will-hut/Rocket_FC/Hardware/Flight_Board/Flight_Board.pdf

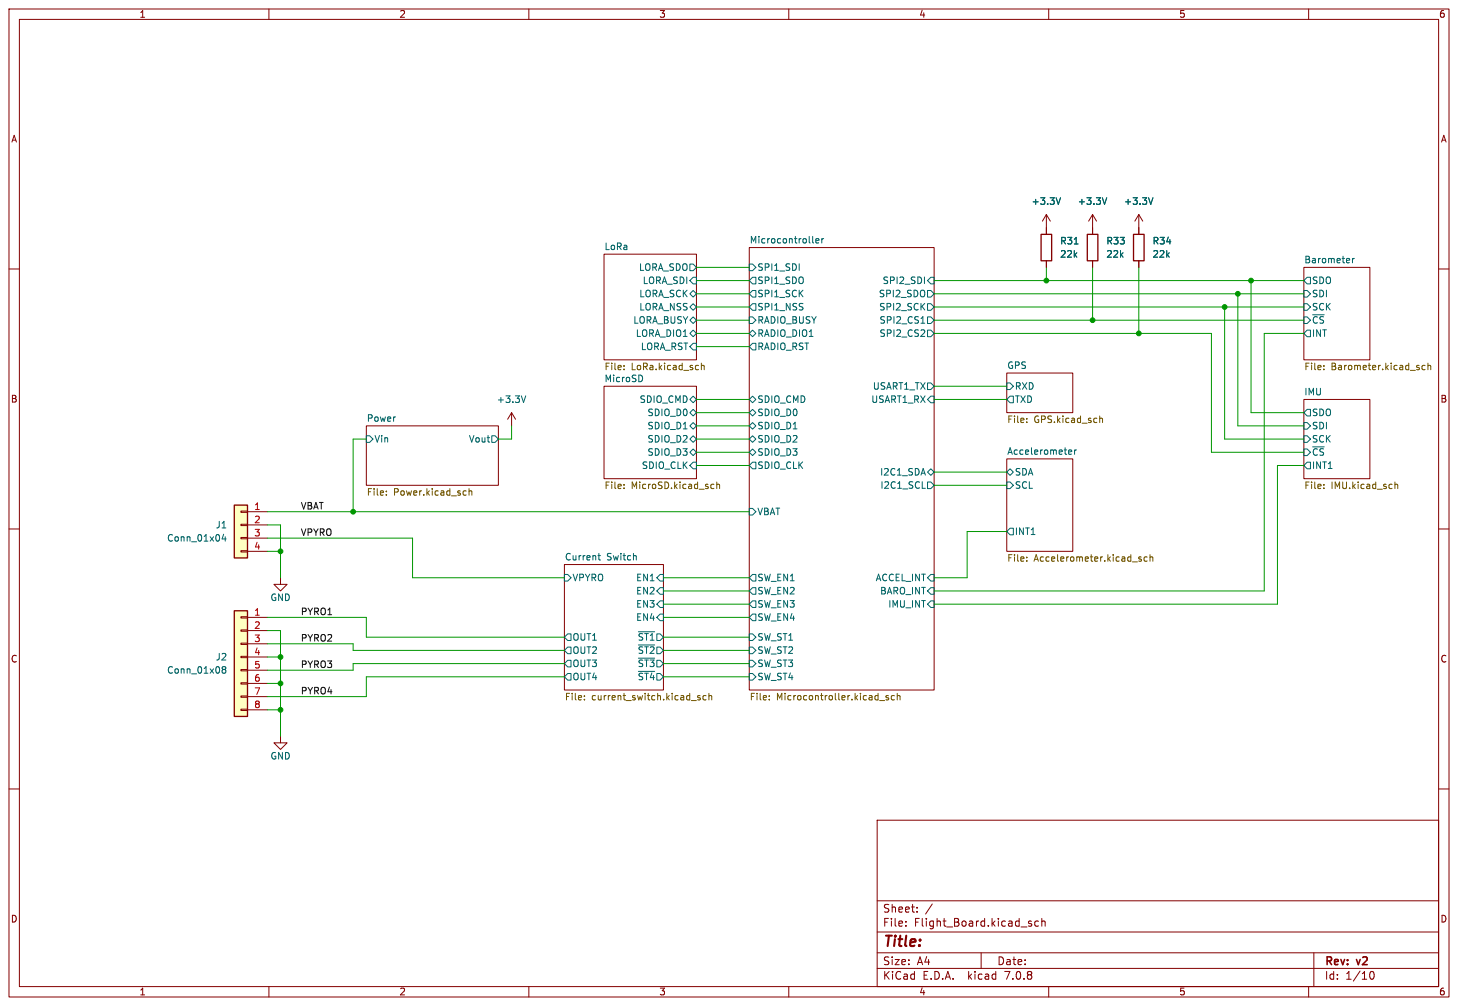
[picture p1: page 1]

INT Barometer File: Barometer.kicad_sch RXD

Id: 1/10 Title: File: Flight_Board.kicad_sch Sheet: /

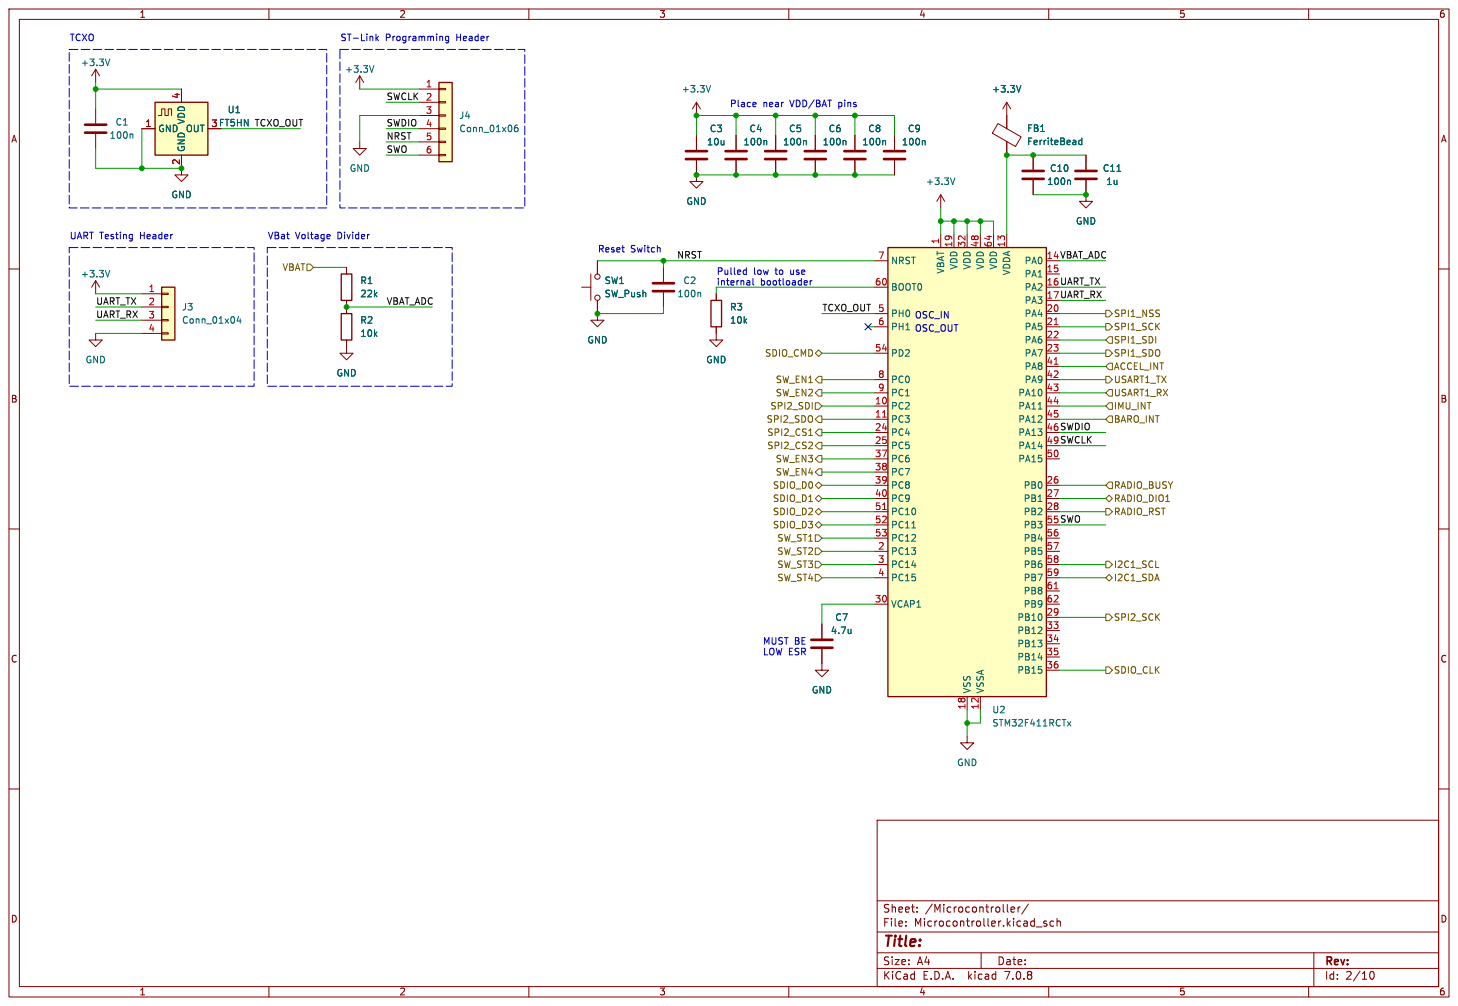
[picture p2: page 2]

UART Testing Header TCXO

TCXO_OUT SWCLK
Place near VDD/BAT pins R1
NRST SWDIO
NRST
SWO

1 PC2 10 PC3 11 VSSA 12 VDDA 13 PA0 14 PA1 15 PA2 16 PA3 17 VSS 18 VDD 19 PC13 2 PA4 20 PA5 21 PA6 22 PA7 23 PC4 24 PC5 25 PB0 26 PB1 27 PB2 28 PB10 29 PC14 3 VCAP1 30 VDD 32 PB12 33 PB13 34 PB14 35 PB15 36 PC6 37 PC7 38 PC8 39 PC15 4 PC9 40 PA8 41 PA9 42 PA10 43 PA11 44 PA12 45 PA13 46 VDD 48 PA14 49 PH0 5 PA15 50 PC10 51 PC11 52 PC12 53 PD2 54 PB3 55 PB4 56 PB5 57 PB6 58 PB7 59 PH1 6 BOOT0 60 PB8 61 PB9 62 VDD 64 NRST 7 PC0 8 PC1 9 U2STM32F411RCTx

Id: 2/10 Title: File: Microcontroller.kicad_sch Sheet: /Microcontroller/

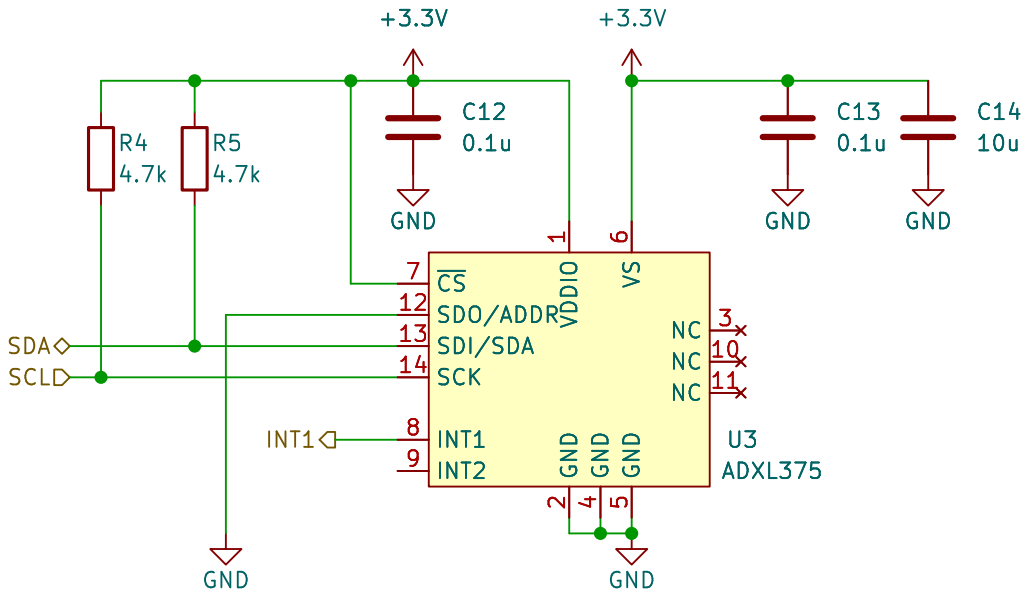
[picture p3: page 3]

1 NC 10 NC 11 SDO/ADDR 12 SDI/SDA 13 SCK 14 GND

Id: 3/10 Title: File: Accelerometer.kicad_sch Sheet: /Accelerometer/

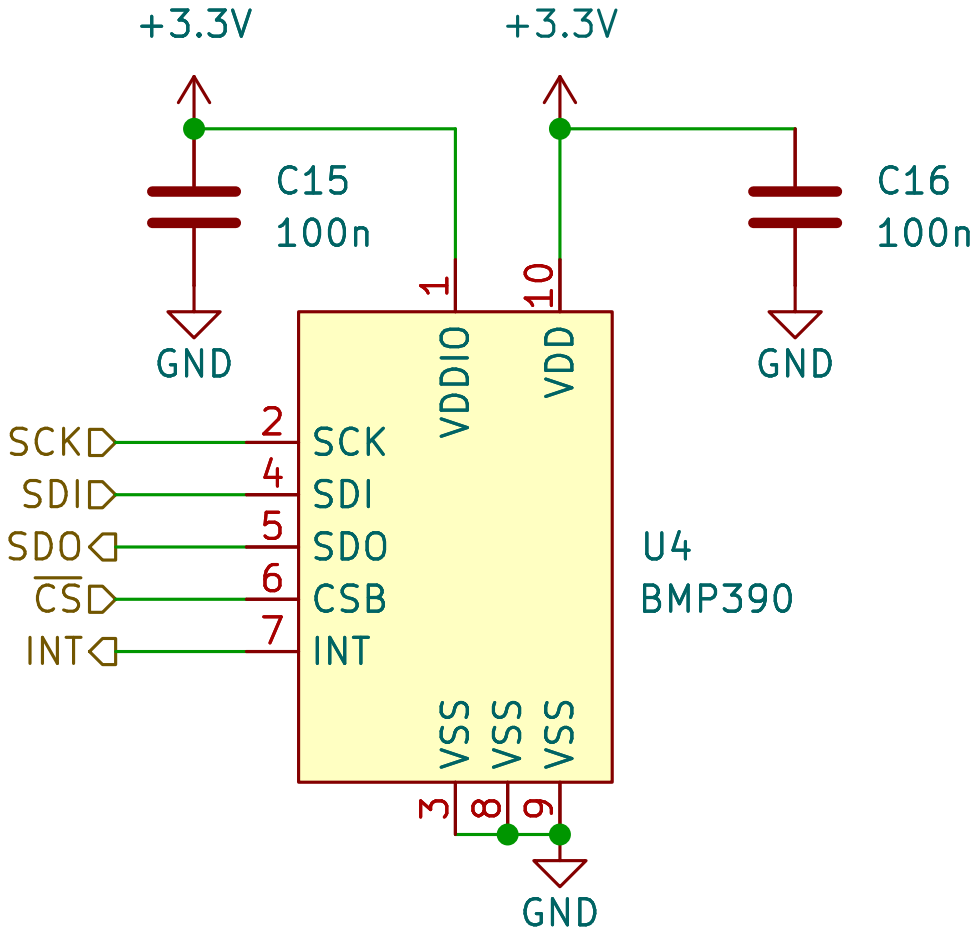
[picture p4: page 4]

Id: 4/10 Title: File: Barometer.kicad_sch Sheet: /Barometer/ VDDIO

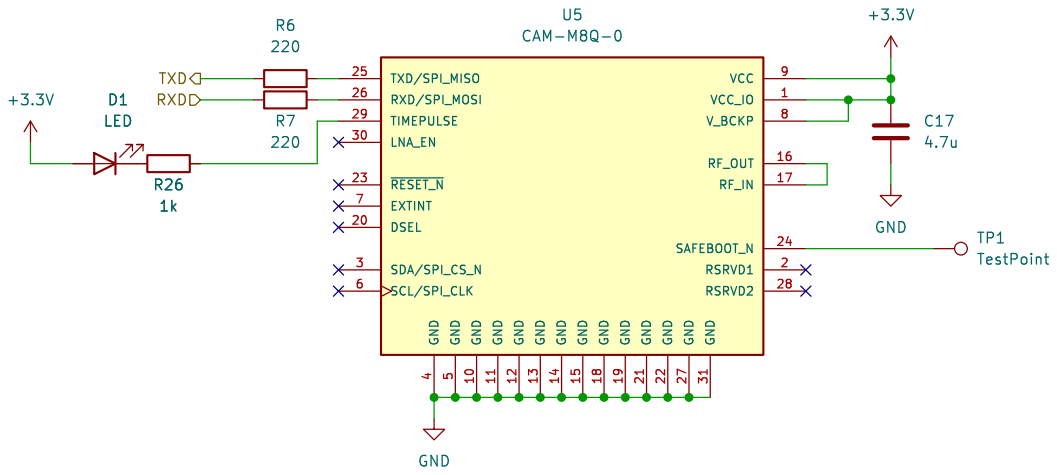
[picture p5: page 5]

5 SCL/SPI_CLK 6 EXTINT 7 V_BCKP 8 VCC 9 U5 CAM-M8Q-0 +3.3V

Id: 5/10 Title: File: GPS.kicad_sch Sheet: /GPS/ GND

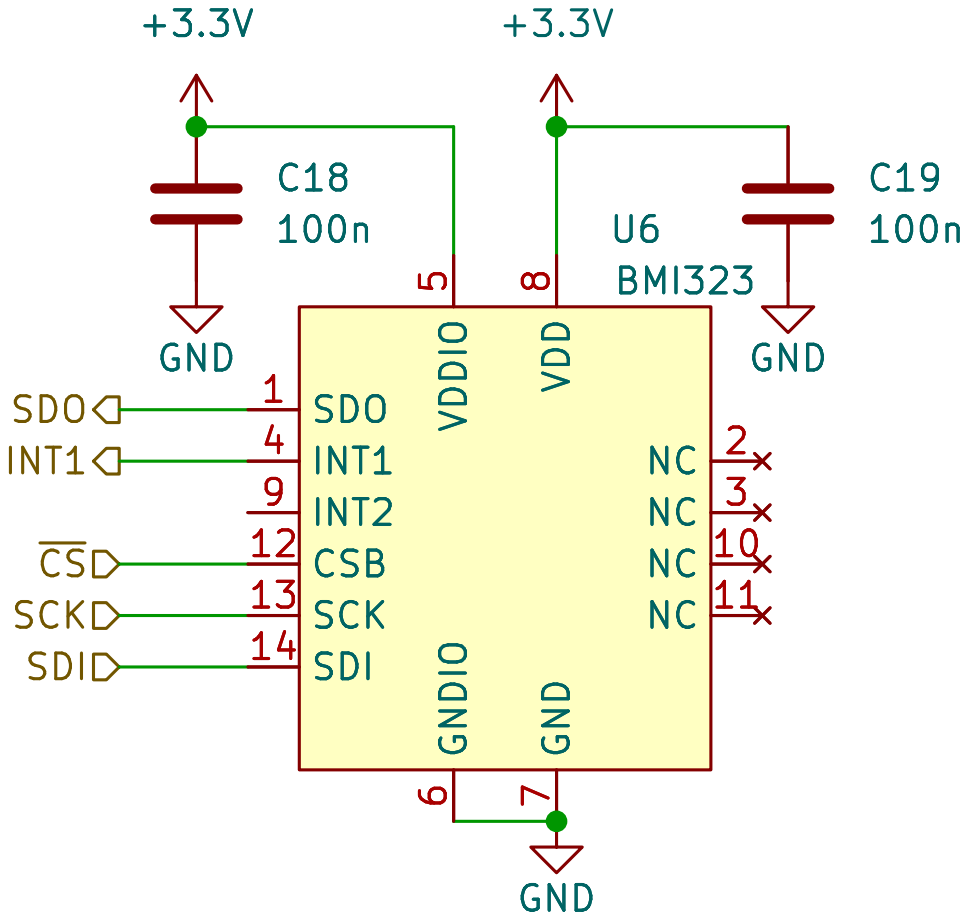
[picture p6: page 6]

Id: 6/10 Title: File: IMU.kicad_sch Sheet: /IMU/ GND

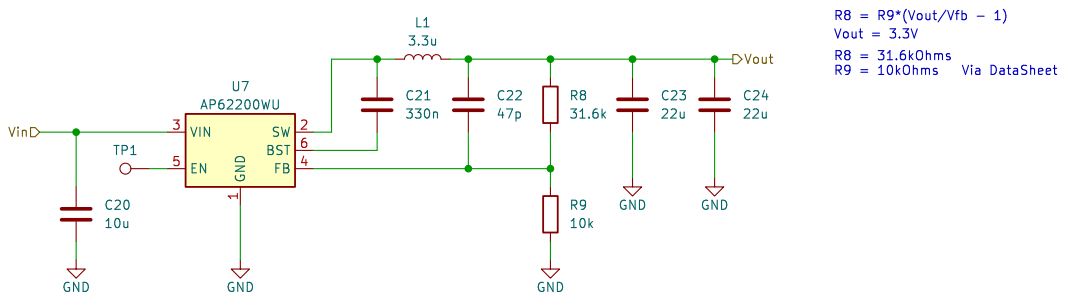
[picture p7: page 7]

1 SW 2 VIN 3 FB 4 EN 5 BST 6 U7 AP62200WU GND

Id: 7/10 Title: File: Power.kicad_sch Sheet: /Power/

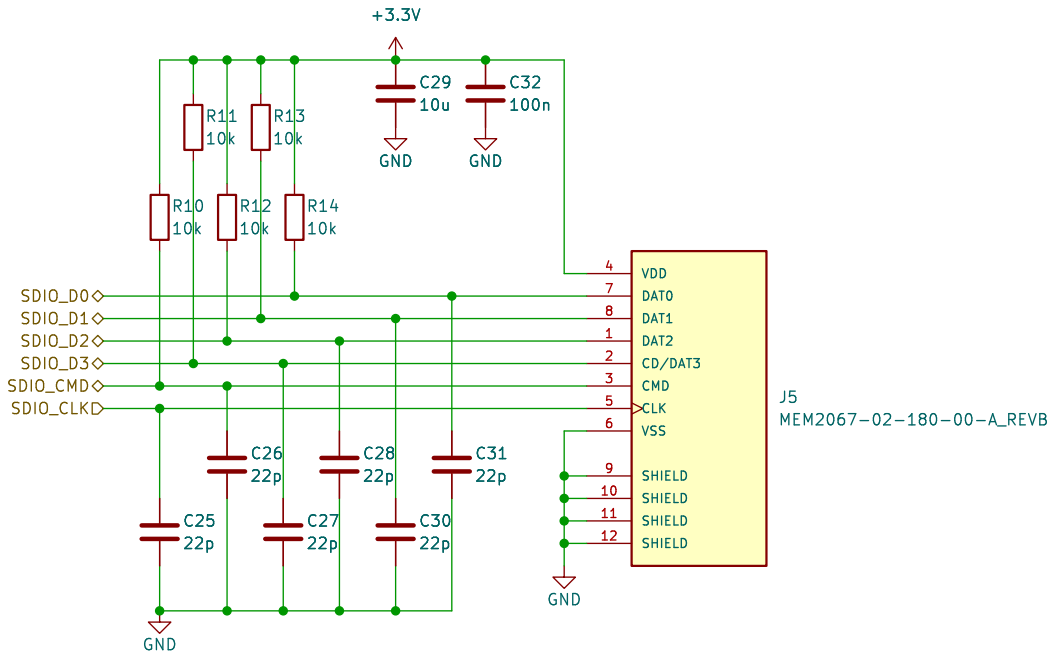
[picture p8: page 8]

Id: 8/10 Title: File: MicroSD.kicad_sch Sheet: /MicroSD/

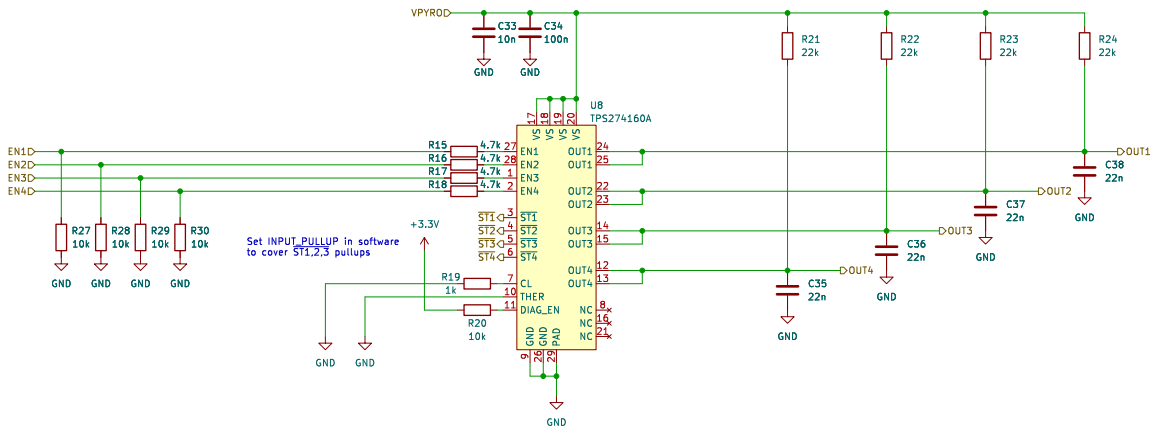
[picture p9: page 9]

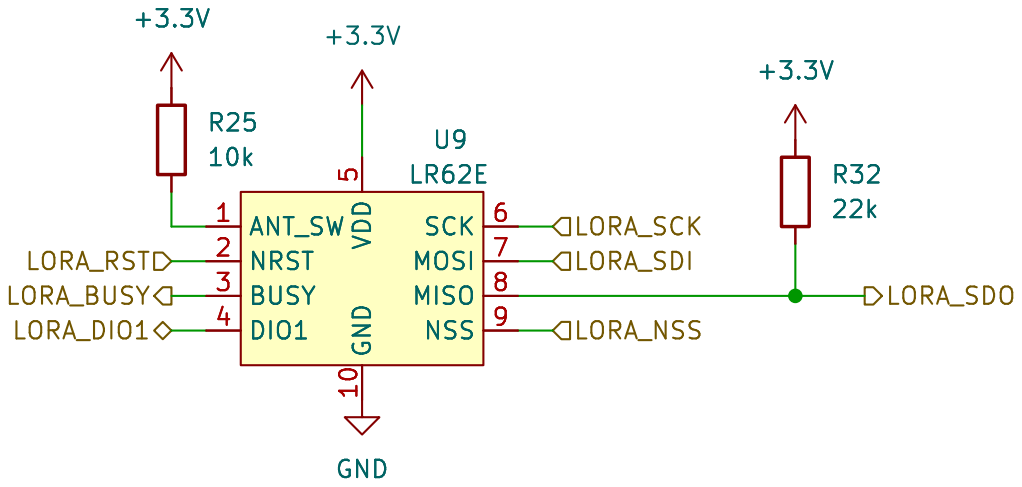
[picture p10: page 10]

5 SCK 6 MOSI 7 MISO 8 NSS 9 U9

5 SCK 6 MOSI 7 MISO 8 NSS 9 GND

Id: 10/10 Title: File: LoRa.kicad_sch Sheet: /LoRa/
