will-hut/Rocket_FC/Hardware/Flight_Board/Flight_Board.kicad_pcb

## KiCad design Hardware/Flight_Board/Flight_Board.kicad_pcb (2023-11-27)

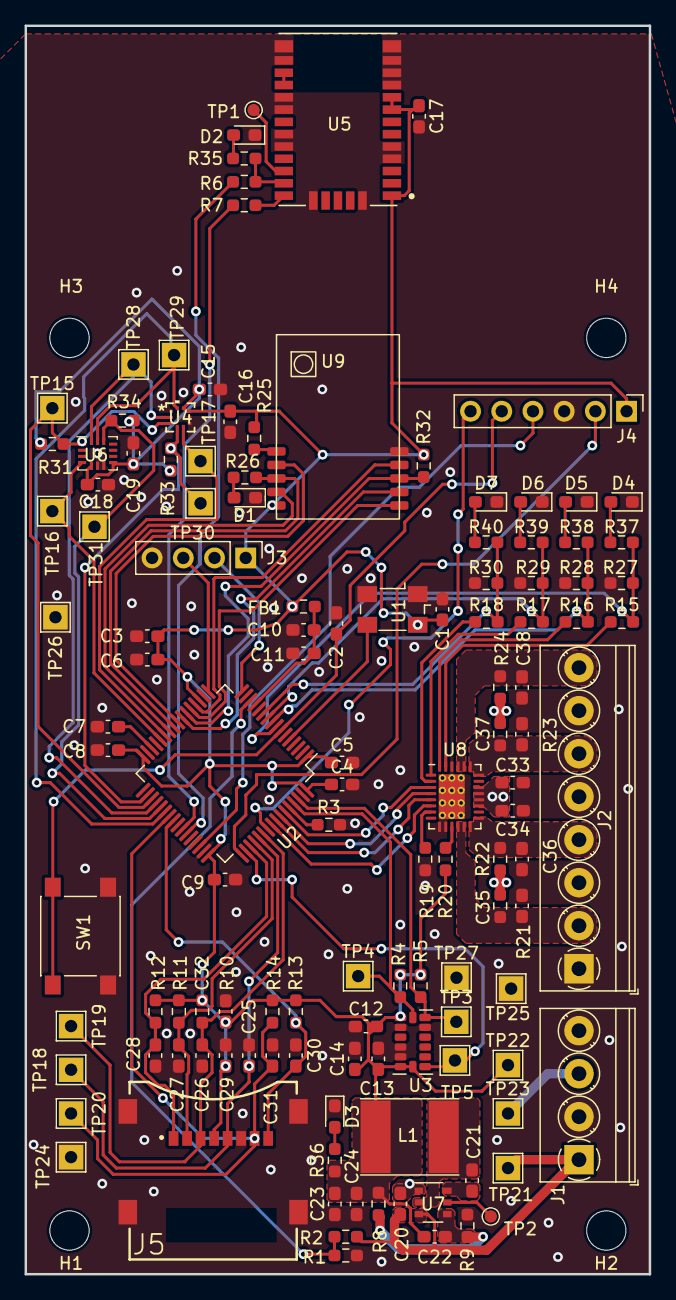
[picture p11: board Flight_Board.kicad_pcb from above]

Board: 2 copper layers, 50.8 x 101.6 mm, 128 parts (0 on the bottom side), 74 nets.

Parts:
C1, C2, C4, C5, C6, C8, C9, C10, C15, C16, C18, C19, C32, C34: 100n; C_0603_1608Metric_Pad1.08x0.95mm_HandSolder
C3, C14, C20, C29: 10u; C_0603_1608Metric_Pad1.08x0.95mm_HandSolder
C7: 4.7u LOWESR; C_0603_1608Metric_Pad1.08x0.95mm_HandSolder
C11: 1u; C_0603_1608Metric_Pad1.08x0.95mm_HandSolder
C12, C13: 0.1u; C_0603_1608Metric_Pad1.08x0.95mm_HandSolder
C17: 4.7u; C_0603_1608Metric_Pad1.08x0.95mm_HandSolder
C21: 330n; C_0603_1608Metric_Pad1.08x0.95mm_HandSolder
C22: 47p; C_0603_1608Metric_Pad1.08x0.95mm_HandSolder
C23, C24: 22u; C_0603_1608Metric_Pad1.08x0.95mm_HandSolder
C25, C26, C27, C28, C30, C31: 22p; C_0603_1608Metric_Pad1.08x0.95mm_HandSolder
C33: 10n; C_0603_1608Metric_Pad1.08x0.95mm_HandSolder
C35, C36, C37, C38: 22n; C_0603_1608Metric_Pad1.08x0.95mm_HandSolder
D1: BUSY; LED_0603_1608Metric_Pad1.05x0.95mm_HandSolder
D2: GPS_TX; LED_0603_1608Metric_Pad1.05x0.95mm_HandSolder
D3: POWER; LED_0603_1608Metric_Pad1.05x0.95mm_HandSolder
D4: P1; LED_0603_1608Metric_Pad1.05x0.95mm_HandSolder
D5: P2; LED_0603_1608Metric_Pad1.05x0.95mm_HandSolder
D6: P3; LED_0603_1608Metric_Pad1.05x0.95mm_HandSolder
D7: P4; LED_0603_1608Metric_Pad1.05x0.95mm_HandSolder
FB1: FerriteBead; R_0603_1608Metric_Pad0.98x0.95mm_HandSolder
H1, H2, H3, H4: MountingHole; MountingHole_3.2mm_M3
J1: Conn_01x04; TerminalBlock_Phoenix_PT-1,5-4-3.5-H_1x04_P3.50mm_Horizontal
J2: Conn_01x08; TerminalBlock_Phoenix_PT-1,5-8-3.5-H_1x08_P3.50mm_Horizontal
J3: Conn_01x04; PinHeader_1x04_P2.54mm_Vertical
J4: Conn_01x06; PinHeader_1x06_P2.54mm_Vertical
J5: MEM2067-02-180-00-A_REVB; GCT_MEM2067-02-180-00-A_REVB
L1: 4.7u; L_Taiyo-Yuden_NR-60xx_HandSoldering
R1, R21, R22, R23, R24, R26, R31, R32, R33, R34, R35, R36, R37, R38, R39, R40: 22k; R_0603_1608Metric_Pad0.98x0.95mm_HandSolder
R2, R3, R9, R10, R11, R12, R13, R14, R20, R25, R27, R28, R29, R30: 10k; R_0603_1608Metric_Pad0.98x0.95mm_HandSolder
R4, R5, R15, R16, R17, R18: 4.7k; R_0603_1608Metric_Pad0.98x0.95mm_HandSolder
R6, R7: 220; R_0603_1608Metric_Pad0.98x0.95mm_HandSolder
R8: 31.6k; R_0603_1608Metric_Pad0.98x0.95mm_HandSolder
R19: 1k; R_0603_1608Metric_Pad0.98x0.95mm_HandSolder
SW1: SW_Push; SW_SPST_PTS645
TP1: SAFEBOOT; TestPoint_Pad_D1.0mm
TP2: EN; TestPoint_Pad_D1.0mm
TP3: SDA; TestPoint_THTPad_2.0x2.0mm_Drill1.0mm
TP4: SCL; TestPoint_THTPad_2.0x2.0mm_Drill1.0mm
TP5: ACC_INT; TestPoint_THTPad_2.0x2.0mm_Drill1.0mm
TP15: MISO; TestPoint_THTPad_2.0x2.0mm_Drill1.0mm
TP16: IMU_INT; TestPoint_THTPad_2.0x2.0mm_Drill1.0mm
TP17: BARO_INT; TestPoint_THTPad_2.0x2.0mm_Drill1.0mm
TP18: SD_CLK; TestPoint_THTPad_2.0x2.0mm_Drill1.0mm
TP19: SD_CMD; TestPoint_THTPad_2.0x2.0mm_Drill1.0mm
TP20: SD_D0; TestPoint_THTPad_2.0x2.0mm_Drill1.0mm
TP21: VBAT; TestPoint_THTPad_2.0x2.0mm_Drill1.0mm
TP22: 3V3; TestPoint_THTPad_2.0x2.0mm_Drill1.0mm
TP23: VPYRO; TestPoint_THTPad_2.0x2.0mm_Drill1.0mm
TP24, TP25, TP26, TP27: GND; TestPoint_THTPad_2.0x2.0mm_Drill1.0mm
TP28: MOSI; TestPoint_THTPad_2.0x2.0mm_Drill1.0mm
TP29: SCK; TestPoint_THTPad_2.0x2.0mm_Drill1.0mm
TP30: CS1; TestPoint_THTPad_2.0x2.0mm_Drill1.0mm
TP31: CS2; TestPoint_THTPad_2.0x2.0mm_Drill1.0mm
U1: FT5HN; Oscillator_SMD_Fox_FT5H_5.0x3.2mm
U2: STM32F411RCTx; LQFP-64_10x10mm_P0.5mm
U3: ADXL375; LGA-14_3x5mm_P0.8mm_LayoutBorder1x6y
U4: BMP390; LGA10_BMP390_BOS
U5: CAM-M8Q-0; LCC100P960X1400X210-31N
U6: BMI323; Bosch_LGA-14_3x2.5mm_P0.5mm
U7: AP62200WU; TSOP-6_1.65x3.05mm_P0.95mm
U8: TPS274160A
U9: LR62E

Connections:
+3.3V: C1.1, C3.1, C4.1, C5.1, C6.1, C8.1, C9.1, C12.2, C13.1, C14.1, C15.1, C16.1, C17.1, C18.1, C19.1, C22.1, C23.1, C24.1, C29.1, C32.1, FB1.1, J3.1, J4.1, J5.4 (VDD), L1.2, R4.1, R5.1, R8.1, R10.1, R11.1, R12.1, R13.1, R14.1, R20.1, R25.1, R31.1, R32.1, R33.1, R34.1, R36.1, TP22.1, U1.4 (VDD), U2.1 (VBAT), U2.19 (VDD), U2.32 (VDD), U2.48 (VDD), U2.64 (VDD), U3.1 (VDDIO), U3.6 (VS), U3.7 (~CS), U4.1 (VDDIO), U4.10 (VDD), U5.1 (VCC_IO), U5.8 (V_BCKP), U5.9 (VCC), U6.5 (VDDIO), U6.8 (VDD), U9.5 (VDD)
/Accelerometer/INT1: TP5.1, U2.50 (PA15), U3.8 (INT1)
/Accelerometer/SCL: R4.2, TP4.1, U2.61 (PB8), U3.14 (SCK)
/Accelerometer/SDA: R5.2, TP3.1, U2.62 (PB9), U3.13 (SDI/SDA)
/Barometer/INT: TP17.1, U2.27 (PB1), U4.7 (INT)
/Barometer/MISO: R31.2, TP15.1, U2.35 (PB14), U4.5 (SDO), U6.1 (SDO)
/Barometer/MOSI: TP28.1, U2.36 (PB15), U4.4 (SDI), U6.14 (SDI)
/Barometer/SCK: TP29.1, U2.38 (PC7), U4.2 (SCK), U6.13 (SCK)
/Barometer/~CS: R33.2, TP30.1, U2.34 (PB13), U4.6 (CSB)
/Current Switch/EN1: R15.1, R27.2, R37.1, U2.8 (PC0)
/Current Switch/EN2: R16.1, R28.2, R38.1, U2.9 (PC1)
/Current Switch/EN3: R17.1, R29.2, R39.1, U2.10 (PC2)
/Current Switch/EN4: R18.1, R30.2, R40.1, U2.11 (PC3)
/Current Switch/~ST1: U2.59 (PB7), U8.3 (~ST1)
/Current Switch/~ST2: U2.58 (PB6), U8.4 (~ST2)
/Current Switch/~ST3: U2.57 (PB5), U8.5 (~ST3)
/Current Switch/~ST4: U2.56 (PB4), U8.6 (~ST4)
/GPS/RXD: R7.1, U2.42 (PA9)
/GPS/TXD: R6.2, U2.43 (PA10)
/IMU/INT1: TP16.1, U2.28 (PB2), U6.4 (INT1)
/IMU/~CS: R34.2, TP31.1, U2.37 (PC6), U6.12 (CSB)
/LoRa/LORA_BUSY: R26.1, U2.25 (PC5), U9.3 (BUSY)
/LoRa/LORA_DIO1: U2.26 (PB0), U9.4 (DIO1)
/LoRa/LORA_MISO: R32.2, U2.22 (PA6), U9.8 (MISO)
/LoRa/LORA_MOSI: U2.23 (PA7), U9.7 (MOSI)
/LoRa/LORA_NSS: U2.20 (PA4), U9.9 (NSS)
/LoRa/LORA_RST: U2.24 (PC4), U9.2 (NRST)
/LoRa/LORA_SCK: U2.21 (PA5), U9.6 (SCK)
/MicroSD/SDIO_CLK: C25.1, J5.5 (CLK), TP18.1, U2.53 (PC12)
/MicroSD/SDIO_CMD: C26.1, J5.3 (CMD), R10.2, TP19.1, U2.54 (PD2)
/MicroSD/SDIO_D0: C31.1, J5.7 (DAT0), R14.2, TP20.1, U2.39 (PC8)
/MicroSD/SDIO_D1: C30.1, J5.8 (DAT1), R13.2, U2.40 (PC9)
/MicroSD/SDIO_D2: C28.1, J5.1 (DAT2), R12.2, U2.51 (PC10)
/MicroSD/SDIO_D3: C27.1, J5.2 (CD/DAT3), R11.2, U2.52 (PC11)
/Microcontroller/NRST: C2.1, J4.5, SW1.2, U2.7 (NRST)
/Microcontroller/SWCLK: J4.2, U2.49 (PA14)
/Microcontroller/SWDIO: J4.4, U2.46 (PA13)
/Microcontroller/SWO: J4.6, U2.55 (PB3)
/Microcontroller/TCXO_OUT: U1.3 (OUT), U2.5 (PH0)
/Microcontroller/UART_RX: J3.3, U2.17 (PA3)
/Microcontroller/UART_TX: J3.2, U2.16 (PA2)
/Microcontroller/VBAT_ADC: R1.2, R2.1, U2.14 (PA0)
/PYRO1: C38.1, J2.8, R24.2, U8.24 (OUT1), U8.25 (OUT1)
/PYRO2: C37.1, J2.6, R23.2, U8.22 (OUT2), U8.23 (OUT2)
/PYRO3: C36.1, J2.4, R22.2, U8.14 (OUT3), U8.15 (OUT3)
/PYRO4: C35.1, J2.2, R21.2, U8.12 (OUT4), U8.13 (OUT4)
/VBAT: C20.1, J1.1, R1.1, TP21.1, U7.3 (VIN)
/VPYRO: C33.1, C34.1, J1.3, R21.1, R22.1, R23.1, R24.1, TP23.1, U8.17 (VS), U8.18 (VS), U8.19 (VS), U8.20 (VS)
GND: C1.2, C2.2, C3.2, C4.2, C5.2, C6.2, C7.2, C8.2, C9.2, C10.2, C11.2, C12.1, C13.2, C14.2, C15.2, C16.2, C17.2, C18.2, C19.2, C20.2, C23.2, C24.2, C25.2, C26.2, C27.2, C28.2, C29.2, C30.2, C31.2, C32.2, C33.2, C34.2, C35.2, C36.2, C37.2, C38.2, D1.1 (K), D2.1 (K), D3.1 (K), D4.1 (K), D5.1 (K), D6.1 (K), D7.1 (K), J1.2, J1.4, J2.1, J2.3, J2.5, J2.7, J3.4, J4.3, J5.6 (VSS), J5.9 (SHIELD), J5.10 (SHIELD), J5.11 (SHIELD), J5.12 (SHIELD), R2.2, R3.2, R9.2, R19.1, R27.1, R28.1, R29.1, R30.1, SW1.1, TP24.1, TP25.1, TP26.1, TP27.1, U1.1 (GND), U1.2 (GND), U2.12 (VSSA), U2.18 (VSS), U2.31 (VSS), U2.47 (VSS), U2.63 (VSS), U3.2 (GND), U3.4 (GND), U3.5 (GND), U3.12 (SDO/ADDR), U4.3 (VSS), U4.8 (VSS), U4.9 (VSS), U5.4 (GND), U5.5 (GND), U5.10 (GND), U5.11 (GND), U5.12 (GND), U5.13 (GND), U5.14 (GND), U5.15 (GND), U5.18 (GND), U5.19 (GND), U5.21 (GND), U5.22 (GND), U5.27 (GND), U5.31 (GND), U6.6 (GNDIO), U6.7 (GND), U7.1 (GND), U8.9 (GND), U8.10 (THER), U8.26 (GND), U8.29 (PAD), U9.10 (GND)
unnamed: D1.2 (A), R26.2
unnamed: D2.2 (A), R35.2
unnamed: D3.2 (A), R36.2
unnamed: D4.2 (A), R37.2
unnamed: D5.2 (A), R38.2
unnamed: D6.2 (A), R39.2
unnamed: D7.2 (A), R40.2
unnamed: R3.1, U2.60 (BOOT0)
unnamed: C7.1, U2.30 (VCAP1)
unnamed: C10.1, C11.1, FB1.2, U2.13 (VDDA)
unnamed: U5.16 (RF_OUT), U5.17 (RF_IN)
unnamed: R7.2, U5.26 (RXD/SPI_MOSI)
unnamed: TP1.1, U5.24 (SAFEBOOT_N)
unnamed: R6.1, R35.1, U5.25 (TXD/SPI_MISO)
unnamed: C21.2, U7.6 (BST)
unnamed: TP2.1, U7.5 (EN)
unnamed: C22.2, R8.2, R9.1, U7.4 (FB)
unnamed: C21.1, L1.1, U7.2 (SW)
unnamed: R19.2, U8.7 (CL)
unnamed: R20.2, U8.11 (DIAG_EN)
unnamed: R15.2, U8.27 (EN1)
unnamed: R16.2, U8.28 (EN2)
unnamed: R17.2, U8.1 (EN3)
unnamed: R18.2, U8.2 (EN4)
unnamed: R25.2, U9.1 (ANT_SW)
