will-hut/Rocket_FC/(commit log)

2023-10-24 add initial hardware symbols/footprints
    [Flight_Board.kicad_pcb, Flight_Board.kicad_sch]
2023-10-26 add main microcontroller schematic
    [Flight_Board.kicad_sch, Microcontroller.kicad_sch]
2023-10-26 Added Pages to Schematic Hierarchy
    Added GPS, Barometer, Accelerometer, and IMU pages. Also included parts on all pages to start schematic design.
    [Accelerometer.kicad_sch, Barometer.kicad_sch, Flight_Board.kicad_sch, GPS.kicad_sch, IMU.kicad_sch]
2023-10-26 Added initial design for Accel.
    Created initial schematics for accelerometer and VS headers on Page 2
    [Accelerometer.kicad_sch, Flight_Board.kicad_sch, Microcontroller.kicad_sch]
2023-10-26 Make Barometer
    [Barometer.kicad_sch, Flight_Board.kicad_sch, GPS.kicad_sch, IMU.kicad_sch]
2023-10-26 Fix Barometer SDO Pin Direction
    [Accelerometer.kicad_sch, Barometer.kicad_sch, Flight_Board.kicad_sch, Microcontroller.kicad_sch]
2023-10-26 standardize connections and create initial spi2 bus
    [Accelerometer.kicad_sch, Barometer.kicad_sch, Flight_Board.kicad_sch, IMU.kicad_sch, Microcontroller.kicad_sch]
2023-10-26 Make GPS
    [Flight_Board.kicad_sch, GPS.kicad_sch]
2023-10-26 move ADLX375 to I2C, bring out more mcu pins, and general touchups
    [Accelerometer.kicad_sch, Flight_Board.kicad_sch, GPS.kicad_sch, Microcontroller.kicad_sch]
2023-10-26 Added Power Page
    Power page added
    [Flight_Board.kicad_sch, Power.kicad_sch]
2023-10-26 fix rx/tx lines
    [Flight_Board.kicad_sch, Power.kicad_sch]
2023-10-27 add MicroSD
    [Flight_Board.kicad_sch, MicroSD.kicad_sch]
2023-10-27 make Current Switch
    [Flight_Board.kicad_sch, current_switch.kicad_sch]
2023-10-27 remove STBar pullups
    note made to toggle internal pullups on mcu to handle external pullups for diagnostic lines
    [Flight_Board.kicad_sch, MicroSD.kicad_sch, current_switch.kicad_sch]
2023-10-27 Added LoRa board sheet and basic component
    [Flight_Board.kicad_sch, LoRa.kicad_sch]
2023-10-27 Updated Lora Board
    [Flight_Board.kicad_sch, LoRa.kicad_sch]
2023-10-27 Update LoRa 2
    [LoRa.kicad_sch]
2023-10-27 fix current limiter
    reverse polarity protection diode&res removed
    split/fix caps on current switch VDD
    [current_switch.kicad_sch]
2023-10-27 connect 4th output channel
    [current_switch.kicad_sch]
2023-10-27 Created power schematic
    [Power.kicad_sch]
2023-10-28 clean up and finalize initial design
    [Accelerometer.kicad_sch, Barometer.kicad_sch, Flight_Board.kicad_sch, GPS.kicad_sch, IMU.kicad_sch, LoRa.kicad_sch, MicroSD.kicad_sch, Microcontroller.kicad_sch]
2023-11-01 Added Mason's Feedback
    [MicroSD.kicad_sch, Power.kicad_sch]
2023-11-01 Clean up, relabel all refdes, and add autosaved files to gitignore
    [Accelerometer.kicad_sch, Barometer.kicad_sch, GPS.kicad_sch, IMU.kicad_sch, LoRa.kicad_sch, MicroSD.kicad_sch, Microcontroller.kicad_sch, Power.kicad_sch]
2023-11-03 clean up, implement suggestions from saunders
    [Accelerometer.kicad_sch, Flight_Board.kicad_sch, GPS.kicad_sch, IMU.kicad_sch, LoRa.kicad_sch, Microcontroller.kicad_sch, current_switch.kicad_sch]
2023-11-03 update revision number to v2
    [Flight_Board.kicad_sch]
2023-11-10 Add LEDs and test points
    [Accelerometer.kicad_sch, Barometer.kicad_sch, Flight_Board.kicad_sch, GPS.kicad_sch, IMU.kicad_sch, LoRa.kicad_sch, MicroSD.kicad_sch, Microcontroller.kicad_sch]
2023-11-10 final touches, bom, footprints
    [Accelerometer.kicad_sch, Barometer.kicad_sch, Flight_Board.kicad_pcb, Flight_Board.kicad_sch, GPS.kicad_sch, IMU.kicad_sch, LoRa.kicad_sch, MicroSD.kicad_sch]
2023-11-13 fix some stuff and begin layout grouping
    [Flight_Board.kicad_pcb, GPS.kicad_sch, MicroSD.kicad_sch]
2023-11-16 Majority of routing attempted
    I got carried away with a lot of random stuff
    [Flight_Board.kicad_pcb]
2023-11-16 route buck and current switch
    [Flight_Board.kicad_pcb, Flight_Board.kicad_sch, current_switch.kicad_sch]
2023-11-17 initial placement on board, continue routing
    [Flight_Board.kicad_pcb, Flight_Board.kicad_sch, GPS.kicad_sch, LoRa.kicad_sch, current_switch.kicad_sch]
2023-11-17 flip mcu pins around, improve routability
    [Flight_Board.kicad_pcb, Microcontroller.kicad_sch]
2023-11-17 Second attempt
    Routing complete, check it out
    [Flight_Board.kicad_pcb]
2023-11-17 add ground plane and begin stitching
    [Flight_Board.kicad_pcb]
2023-11-18 stitch ground plane
    [Flight_Board.kicad_pcb]
2023-11-18 fix remaining drc errors
    hole sizes for current switch increased
    [Flight_Board.kicad_pcb]
2023-11-20 begin fixing silkscreen
    [Flight_Board.kicad_pcb]
2023-11-20 change current switch footprint
2023-11-20 edit pcb with new footprint
    [Flight_Board.kicad_pcb, current_switch.kicad_sch]
2023-11-27 update silkscreen
    [Flight_Board.kicad_pcb]
